ericklein/Signal-Tower/secrets_template.h

// Home (Local) wifi credentials
#define WIFI_SSID  "--YOUR-WIFI-SSID-HERE--"
#define WIFI_PASS "--YOUR-WIFI-PASSWORD-HERE--"

// Set server configuration for MQTT
#define MQTT_PORT 1883
#define MQTT_USER "--MQTT-USER-ID--"
#define MQTT_BROKER "homeassistant.local"
#define MQTT_PASS "--MQTT-PASSWORD--"

// Device ID used for MQTT 
#define DEVICE_ID        "signal-tower"
